AntennaNaStolbe/SmartDoorBell/3D models/MainBox_white.stl

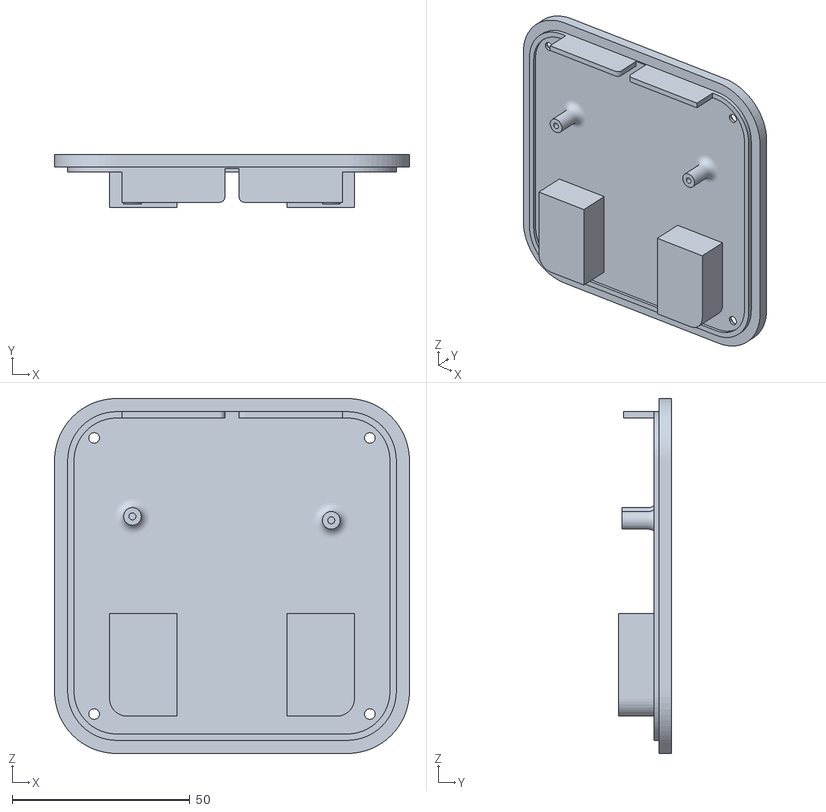
[picture p3: CAD file, 2026-11-14]
3D models/MainBox_white.stl
100.0 x 15.0 x 100.0
