AntennaNaStolbe/SmartDoorBell/3D models/MainBox2_white.stl

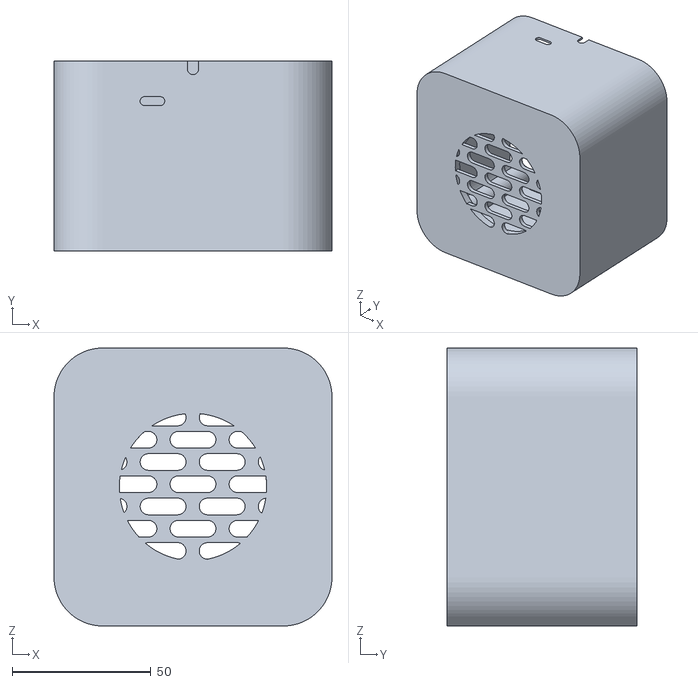
[picture p4: CAD file, 2026-11-14]
3D models/MainBox2_white.stl
100.0 x 68.5 x 100.0
