AntennaNaStolbe/SmartDoorBell/3D models/button_bell_black.stl

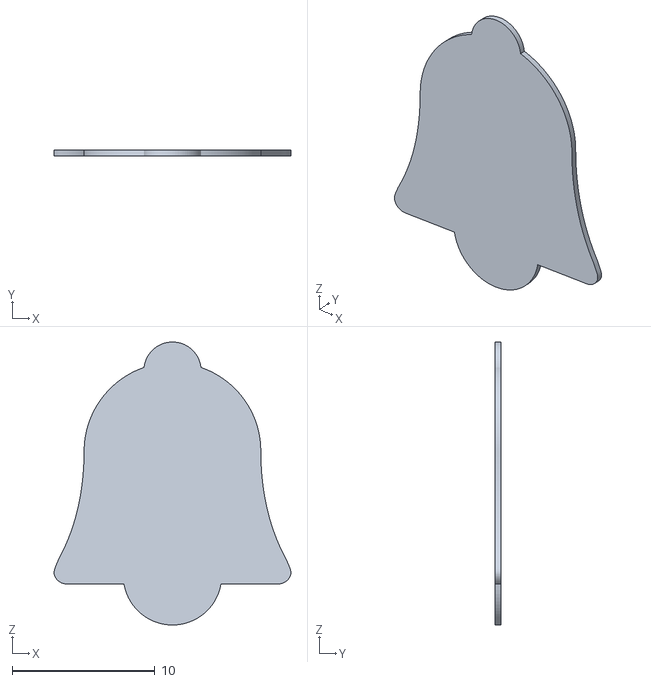
[picture p5: CAD file, 2026-11-14]
3D models/button_bell_black.stl
16.6 x 0.4 x 19.8
