AntennaNaStolbe/SmartDoorBell/3D models/button_ring_black.stl

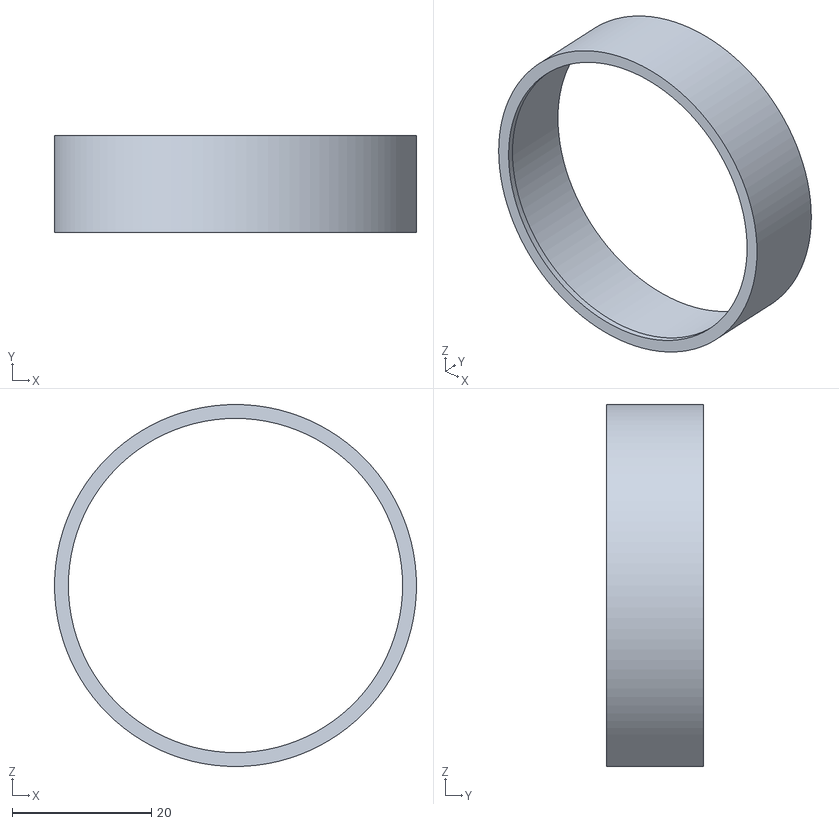
[picture p6: CAD file, 2026-11-08]
3D models/button_ring_black.stl
52.0 x 14.0 x 52.0
