AntennaNaStolbe/SmartDoorBell/3D models/button_white.stl

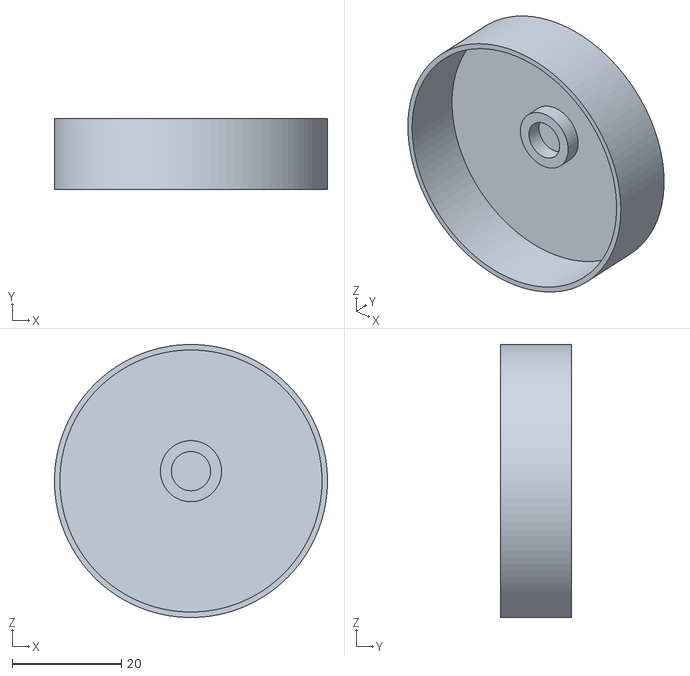
[picture p7: CAD file, 2026-11-08]
3D models/button_white.stl
50.0 x 13.0 x 50.0
