AntennaNaStolbe/SmartDoorBell/(list of files, cad)

Other CAD files:
3D models/SmartDoorBell.f3d
