AntennaNaStolbe/SmartDoorBell/(commit log)

2026-11-01 Initial ESP32-C6 LED strip firmware
2026-11-08 Add Zigbee doorbell, light control, and OTA support
    [MainBox2_white.stl, MainBox_white.stl, bell_black.stl, button_white.stl, down_black.stl, koltso_black.stl, partitions_zigbee_zczr.csv]
2026-11-14 Use built-in Zigbee OTA handler and update enclosure assets
    [MainBox2_white.stl, MainBox_white.stl, SmartDoorBell.f3d, bell_black.stl, button_bell_black.stl, button_ring_black.stl, down_black.stl]
